cryptotronix/breakingbitcoin-hw/Graphics/BB2.bmp

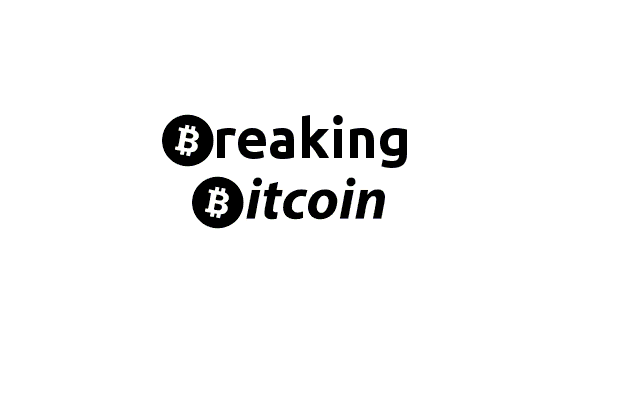
Graphics/BB2.bmp
