cryptotronix/breakingbitcoin-hw/Graphics/BBB.png

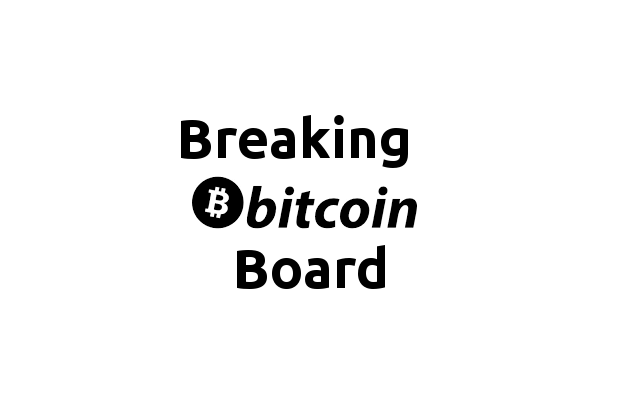
Graphics/BBB.png
