cryptotronix/breakingbitcoin-hw/Graphics/bitcoin.png

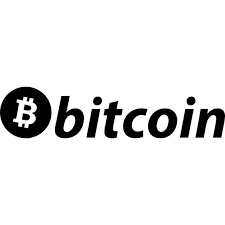
Graphics/bitcoin.png
