cryptotronix/breakingbitcoin-hw/Graphics/Cryptotronix.bmp

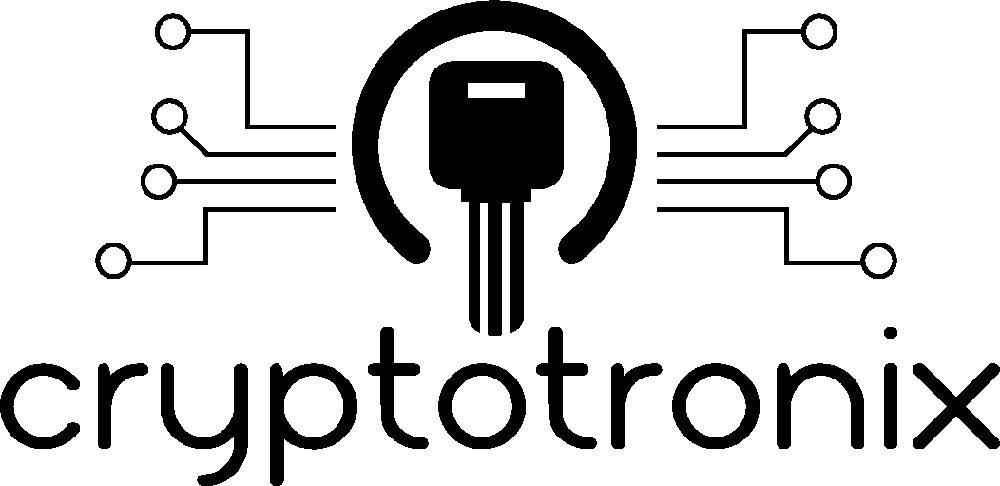
Graphics/Cryptotronix.bmp
