cryptotronix/breakingbitcoin-hw/Rev B/breaking_bitcoin-schematic.pdf

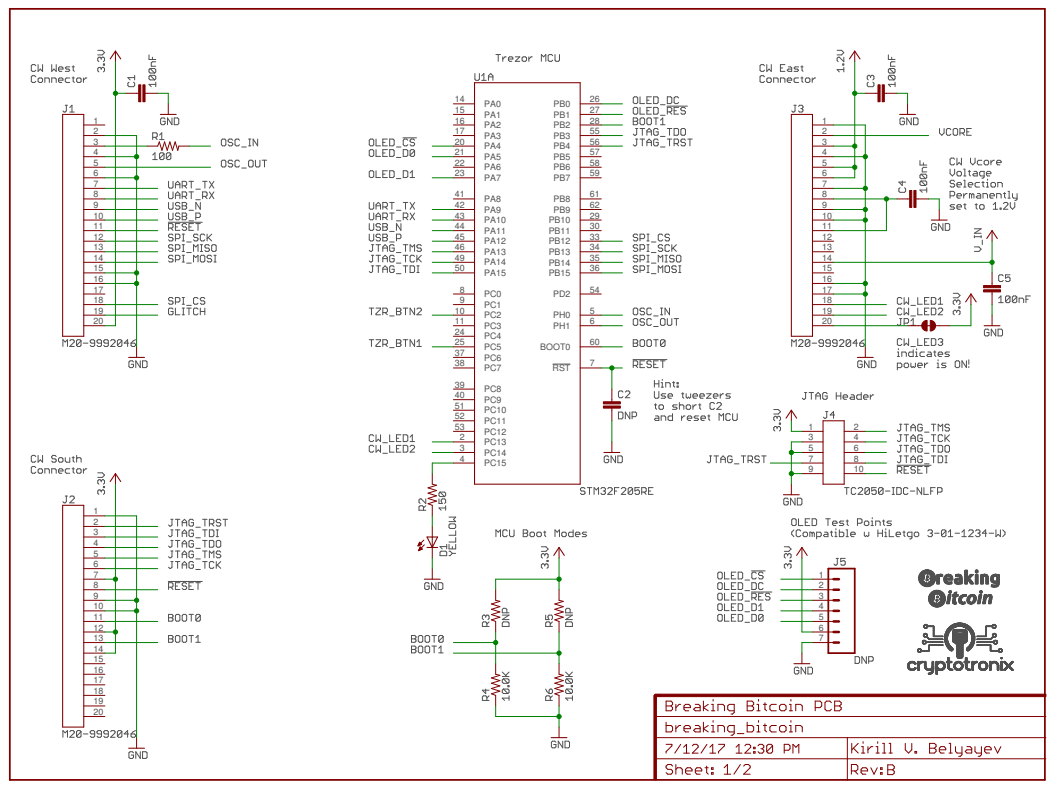
[picture p5: page 1]

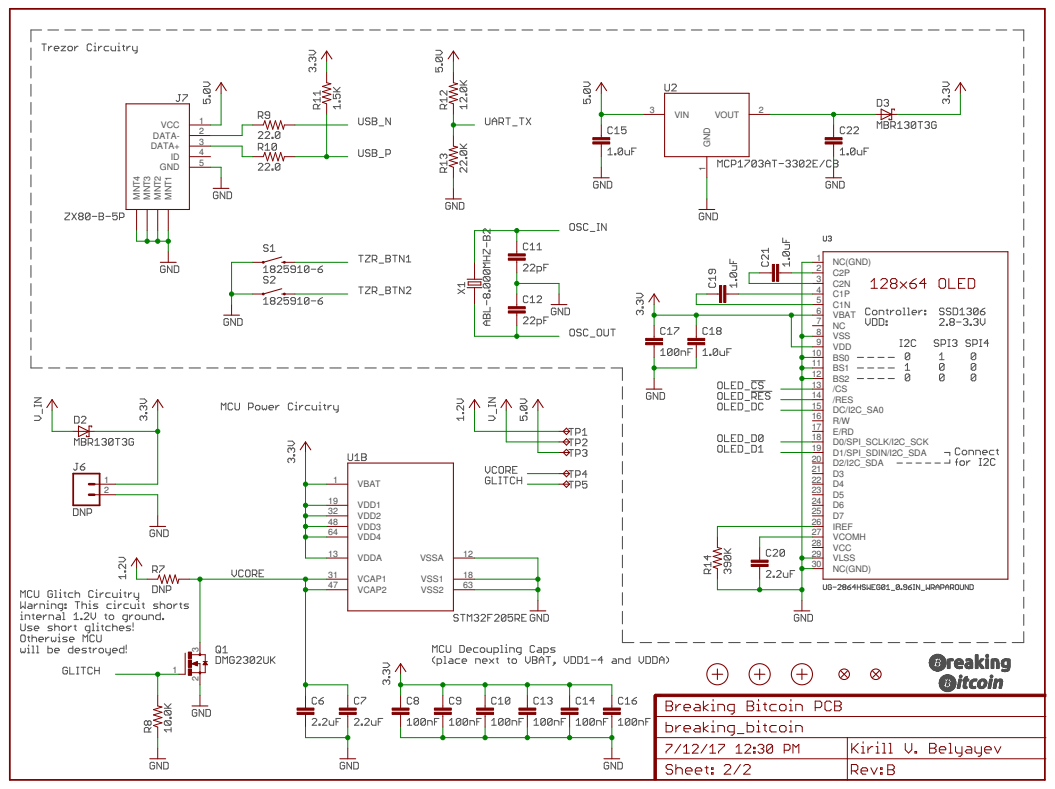
[picture p6: page 2]
