cryptotronix/breakingbitcoin-hw/Rev B/breaking_bitcoin-bottom.pdf

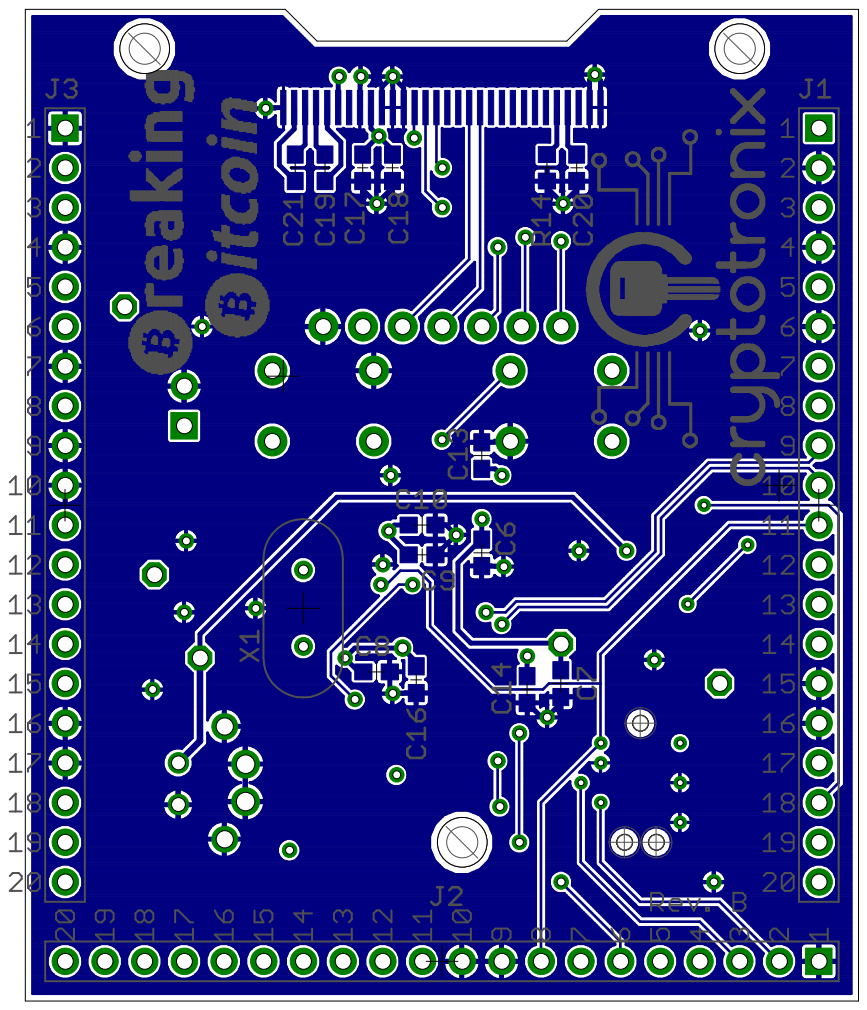
[picture p7: page 1]
