cryptotronix/breakingbitcoin-hw/Rev B/breaking_bitcoin-dimensions.pdf

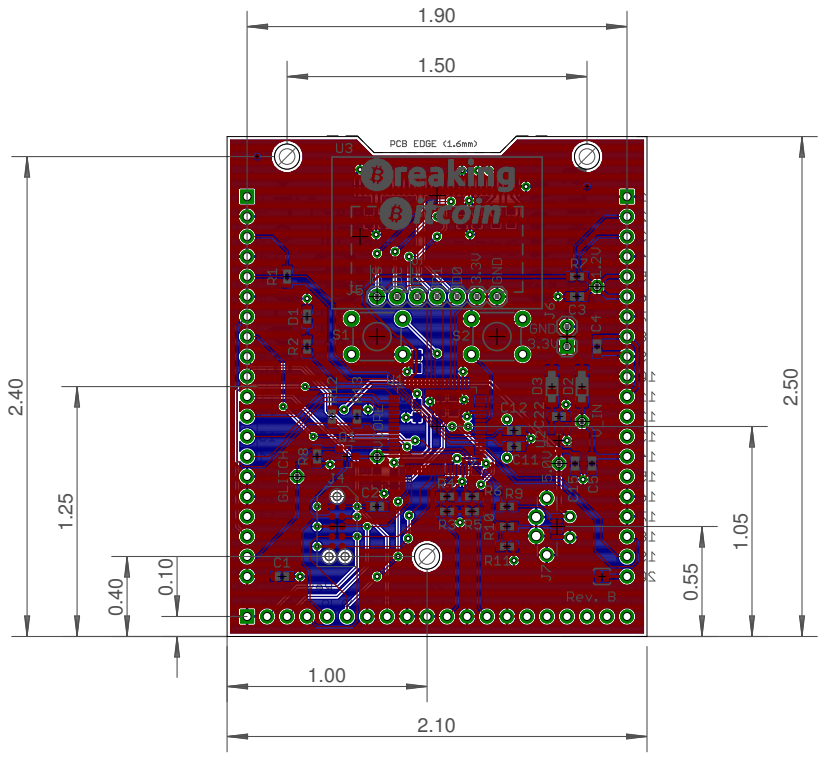
[picture p8: page 1]
