cryptotronix/breakingbitcoin-hw/Rev B/breaking_bitcoin-top.pdf

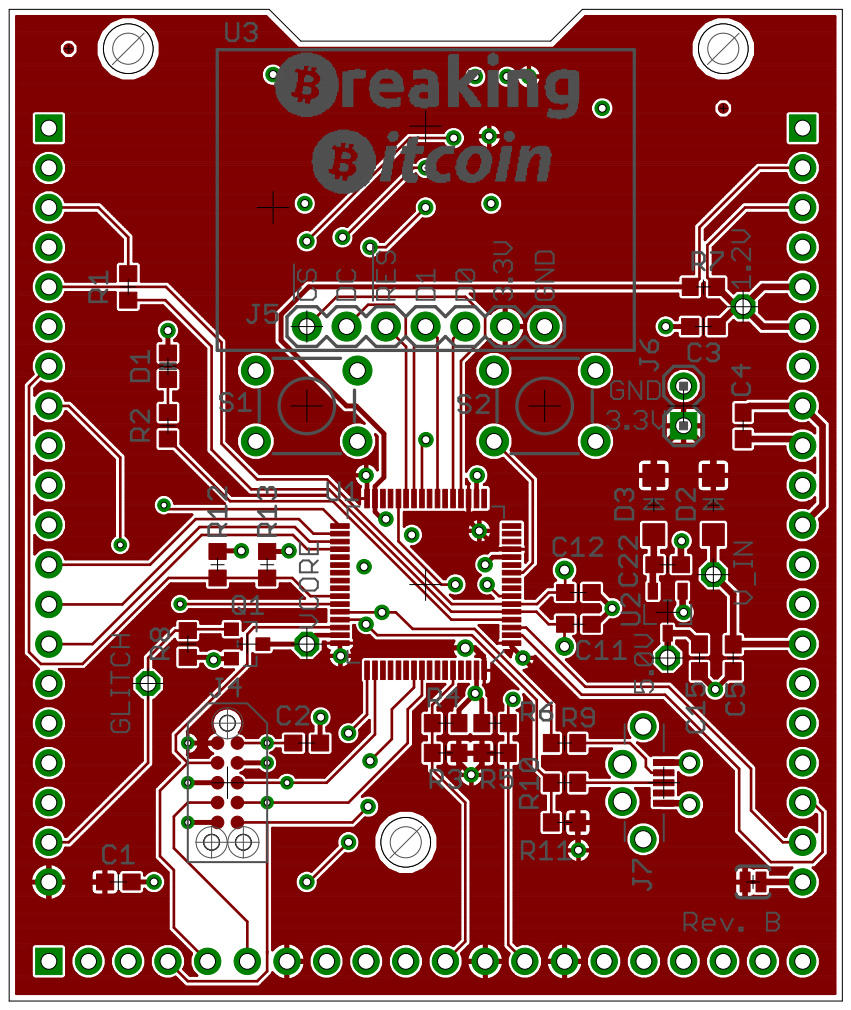
[picture p9: page 1]
