cryptotronix/breakingbitcoin-hw/Rev A/breaking_bitcoin-schematic.pdf

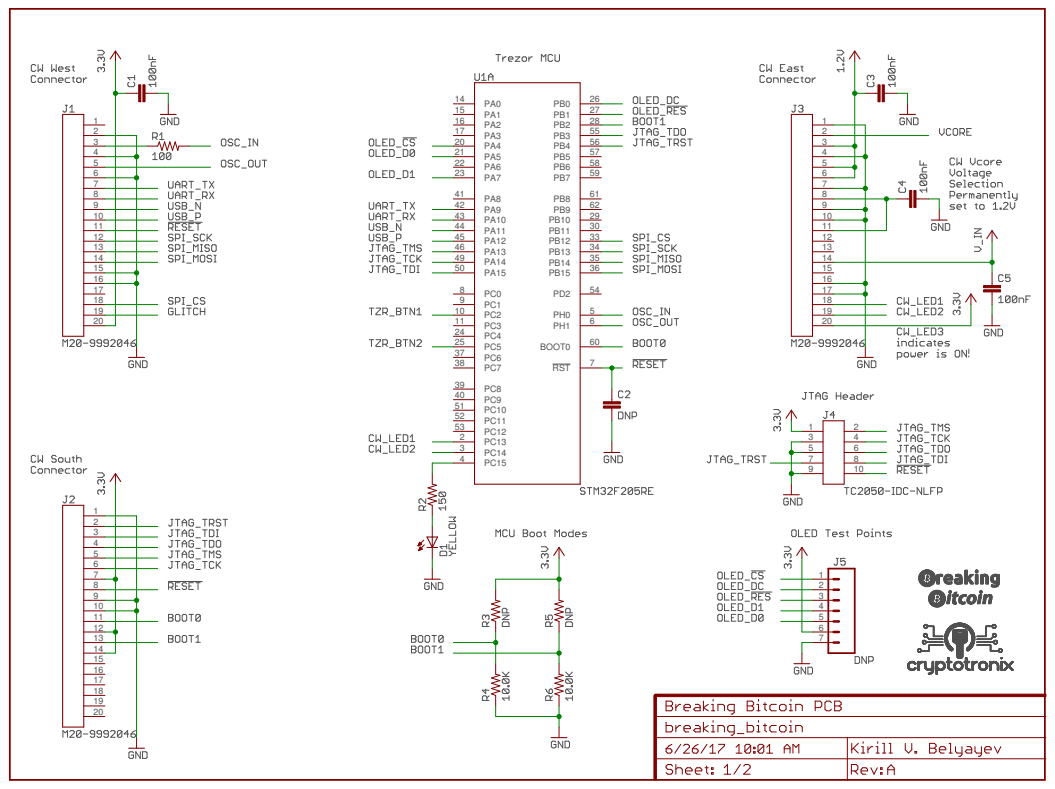
[picture p10: page 1]

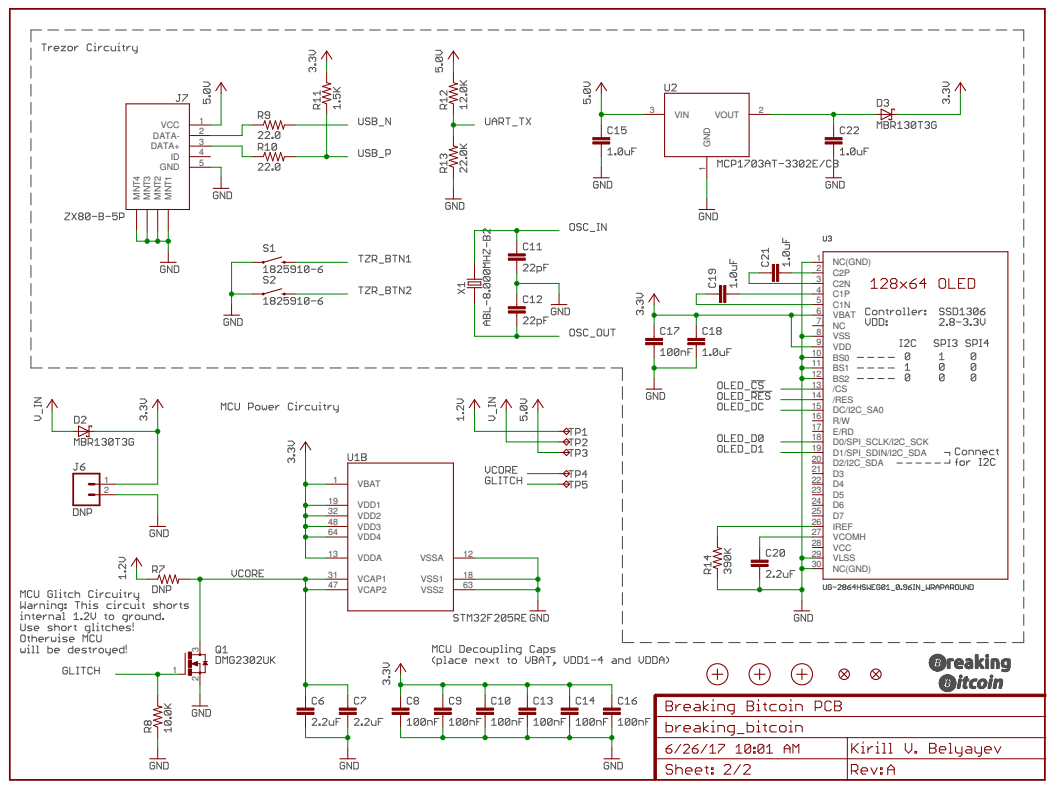
[picture p11: page 2]
