cryptotronix/breakingbitcoin-hw/Rev A/breaking_bitcoin-bottom.pdf

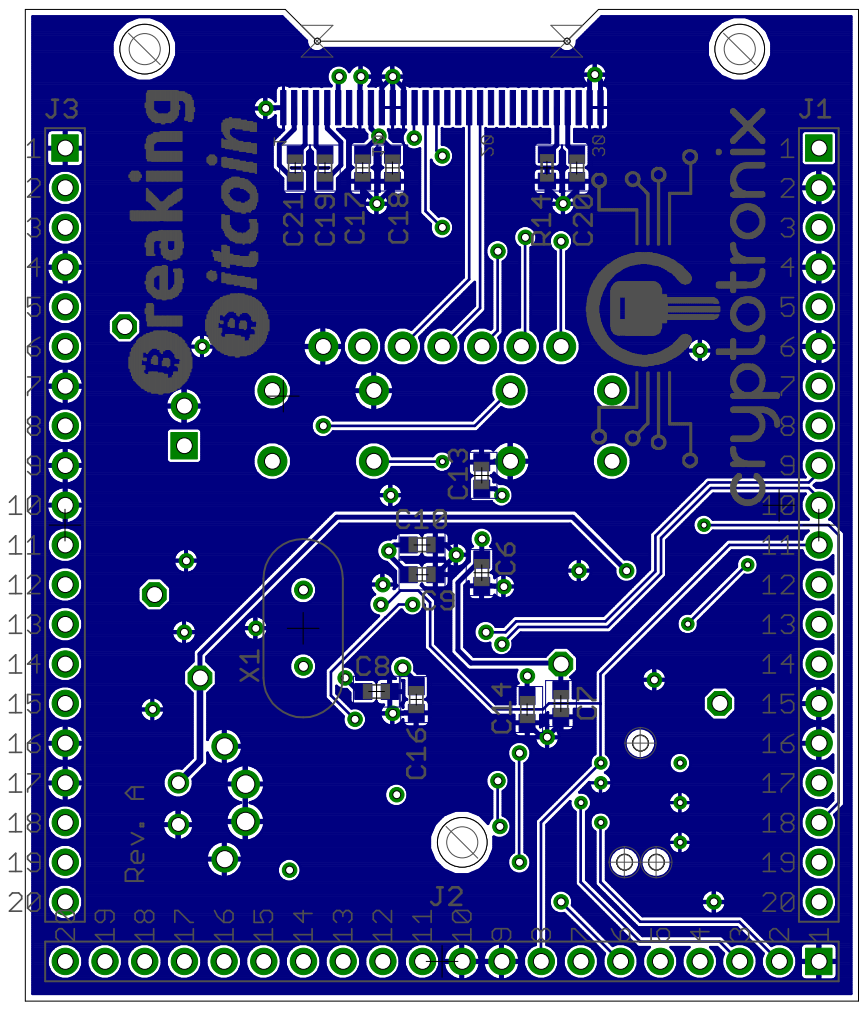
[picture p12: page 1]
