cryptotronix/breakingbitcoin-hw/Rev A/breaking_bitcoin-dimensions.pdf

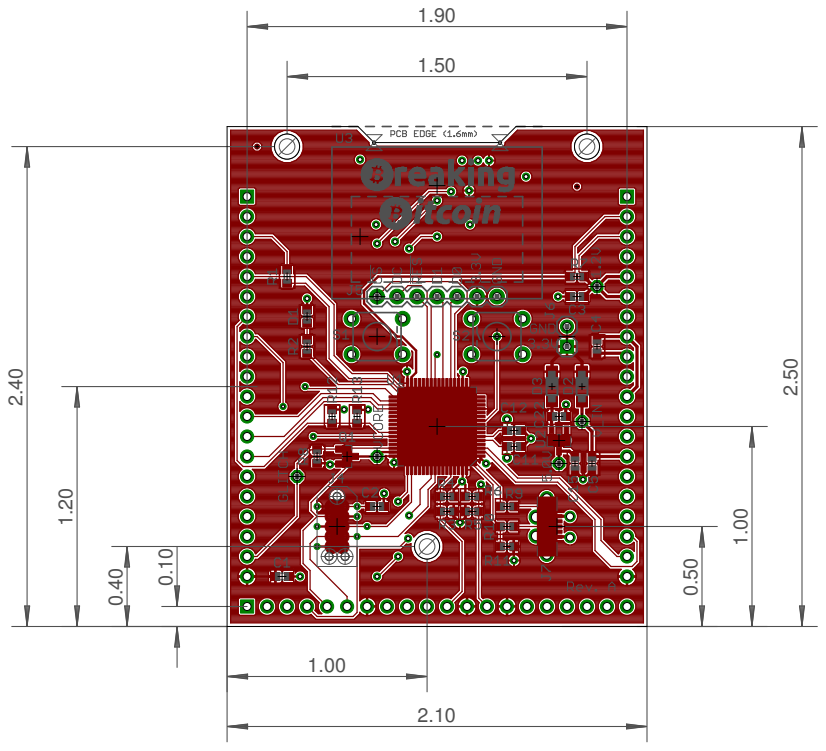
[picture p13: page 1]
