cryptotronix/breakingbitcoin-hw/Rev A/breaking_bitcoin-top.pdf

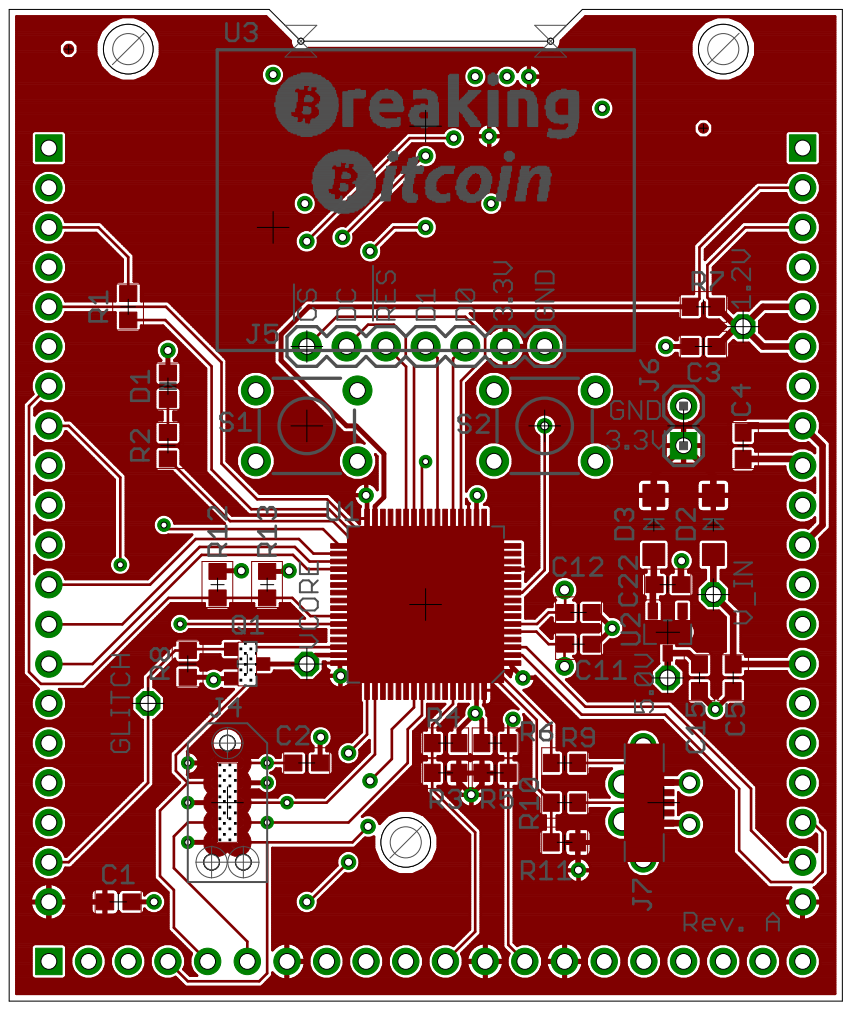
[picture p14: page 1]
