cryptotronix/breakingbitcoin-hw/Rev B/breaking_bitcoin.brd

## EAGLE design Rev B/breaking_bitcoin.brd (2017-07-13)

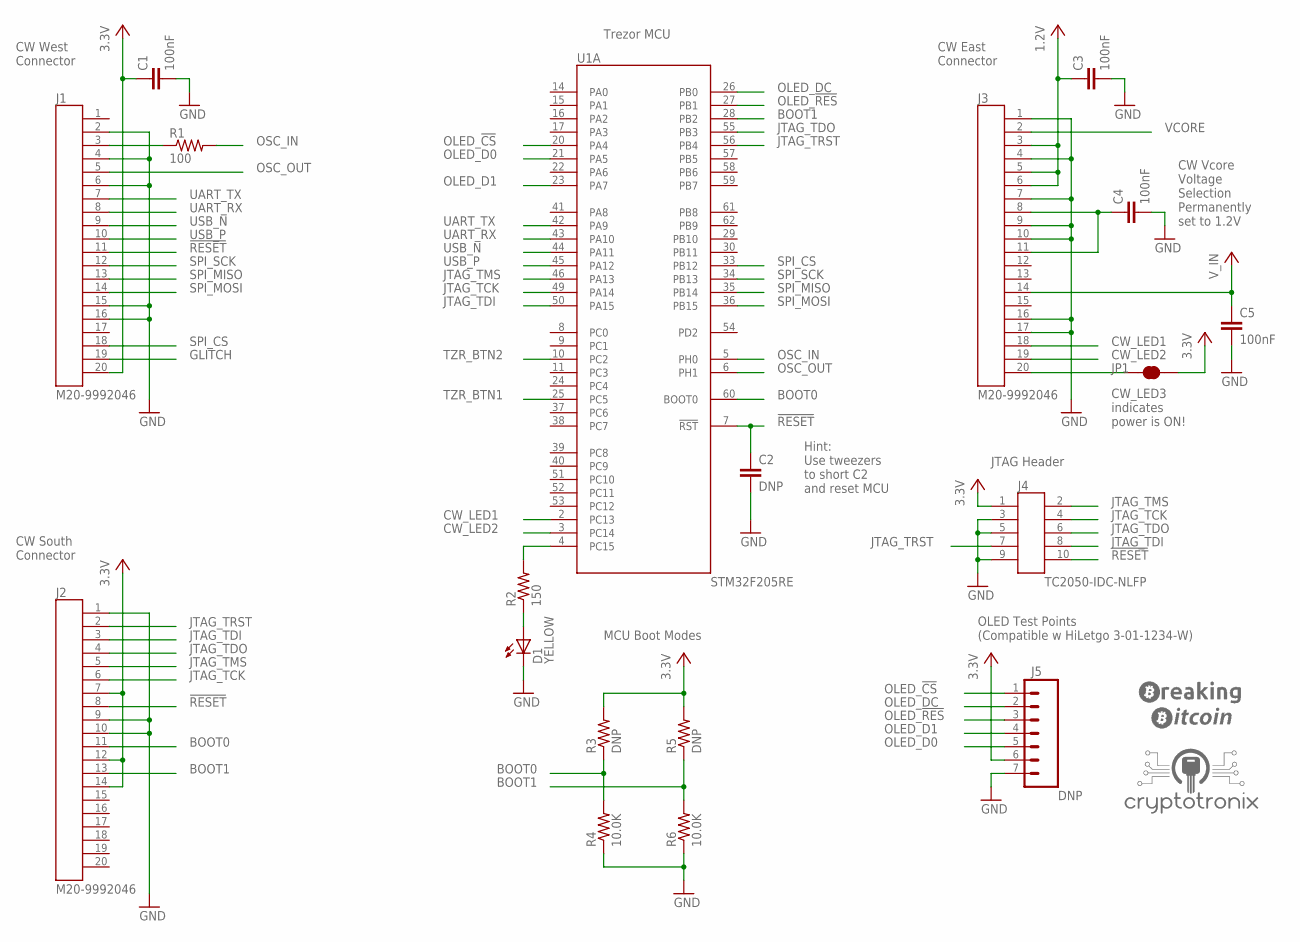
[picture p15: schematic breaking_bitcoin.sch, sheet 1]

Parts:
C1, C3, C4, C5: 100nF; C0603
C2: DNP; C0603
D1: YELLOW; 0603
J1, J2, J3: M20-9992046
J4: TC2050-IDC-NLFP
J5: DNP; 1X07
JP1: JUMPER-PAD-2-NC_BY_TRACE; PAD-JUMPER-2-NC_BY_TRACE_YES_SILK
R1: 100; R0603
R2: 150; R0603
R3, R5: DNP; R0603
R4, R6: 10.0K; R0603
U1: STM32F205RE; LQFP64
U$1: BB_LOGO
U$2: CRYPTOTRONIX_LOGO

Connections:
0V: C1.2, C2.2, C3.2, C4.2, C5.2, D1.C, J1.2, J1.4, J1.6, J1.15, J1.16, J2.1, J2.9, J2.10, J3.1, J3.4, J3.7, J3.9, J3.10, J3.16, J3.17, J4.3, J4.5, J4.9, J5.7, R4.1, R6.1; also elsewhere on the board
1.2V: C3.1, J3.3, J3.5, J3.6; also elsewhere on the board
3.3V: C1.1, J1.20, J2.7, J2.12, J2.14, J4.1, J5.6, JP1.2, R3.2, R5.2; also elsewhere on the board
!RESET: C2.1, J1.11, J2.8, J4.10, U1.7 (!RST)
BOOT0: J2.11, R3.1, R4.2, U1.60 (BOOT0)
BOOT1: J2.13, R5.1, R6.2, U1.28 (PB2)
CW_LED1: J3.18, U1.2 (PC13)
CW_LED2: J3.19, U1.3 (PC14)
GLITCH: J1.19; also elsewhere on the board
JTAG_TCK: J2.6, J4.4, U1.49 (PA14)
JTAG_TDI: J2.3, J4.8, U1.50 (PA15)
JTAG_TDO: J2.4, J4.6, U1.55 (PB3)
JTAG_TMS: J2.5, J4.2, U1.46 (PA13)
JTAG_TRST: J2.2, J4.7, U1.56 (PB4)
unnamed: J1.3, R1.1
unnamed: R2.2, U1.4 (PC15)
unnamed: C4.1, J3.8, J3.11
unnamed: D1.A, R2.1
unnamed: J3.20, JP1.1
OLED_!CS: J5.1, U1.20 (PA4); also elsewhere on the board
OLED_!RES: J5.3, U1.27 (PB1); also elsewhere on the board
OLED_D0: J5.5, U1.21 (PA5); also elsewhere on the board
OLED_D1: J5.4, U1.23 (PA7); also elsewhere on the board
OLED_DC: J5.2, U1.26 (PB0); also elsewhere on the board
OSC_IN: R1.2, U1.5 (PH0); also elsewhere on the board
OSC_OUT: J1.5, U1.6 (PH1); also elsewhere on the board
SPI_CS: J1.18, U1.33 (PB12)
SPI_MISO: J1.13, U1.35 (PB14)
SPI_MOSI: J1.14, U1.36 (PB15)
SPI_SCK: J1.12, U1.34 (PB13)
TZR_BTN1: U1.25 (PC5); also elsewhere on the board
TZR_BTN2: U1.10 (PC2); also elsewhere on the board
UART_RX: J1.8, U1.43 (PA10)
UART_TX: J1.7, U1.42 (PA9); also elsewhere on the board
USB_N: J1.9, U1.44 (PA11); also elsewhere on the board
USB_P: J1.10, U1.45 (PA12); also elsewhere on the board
VCORE: J3.2; also elsewhere on the board
V_IN: C5.1, J3.14; also elsewhere on the board

Notes on the sheet:
Trezor MCU
CW West Connector
CW South Connector
CW East Connector
JTAG Header
MCU Boot Modes
CW Vcore Voltage Selection Permanently set to 1.2V
CW_LED3 indicates power is ON!
OLED Test Points (Compatible w HiLetgo 3-01-1234-W)
Hint: Use tweezers to short C2 and reset MCU

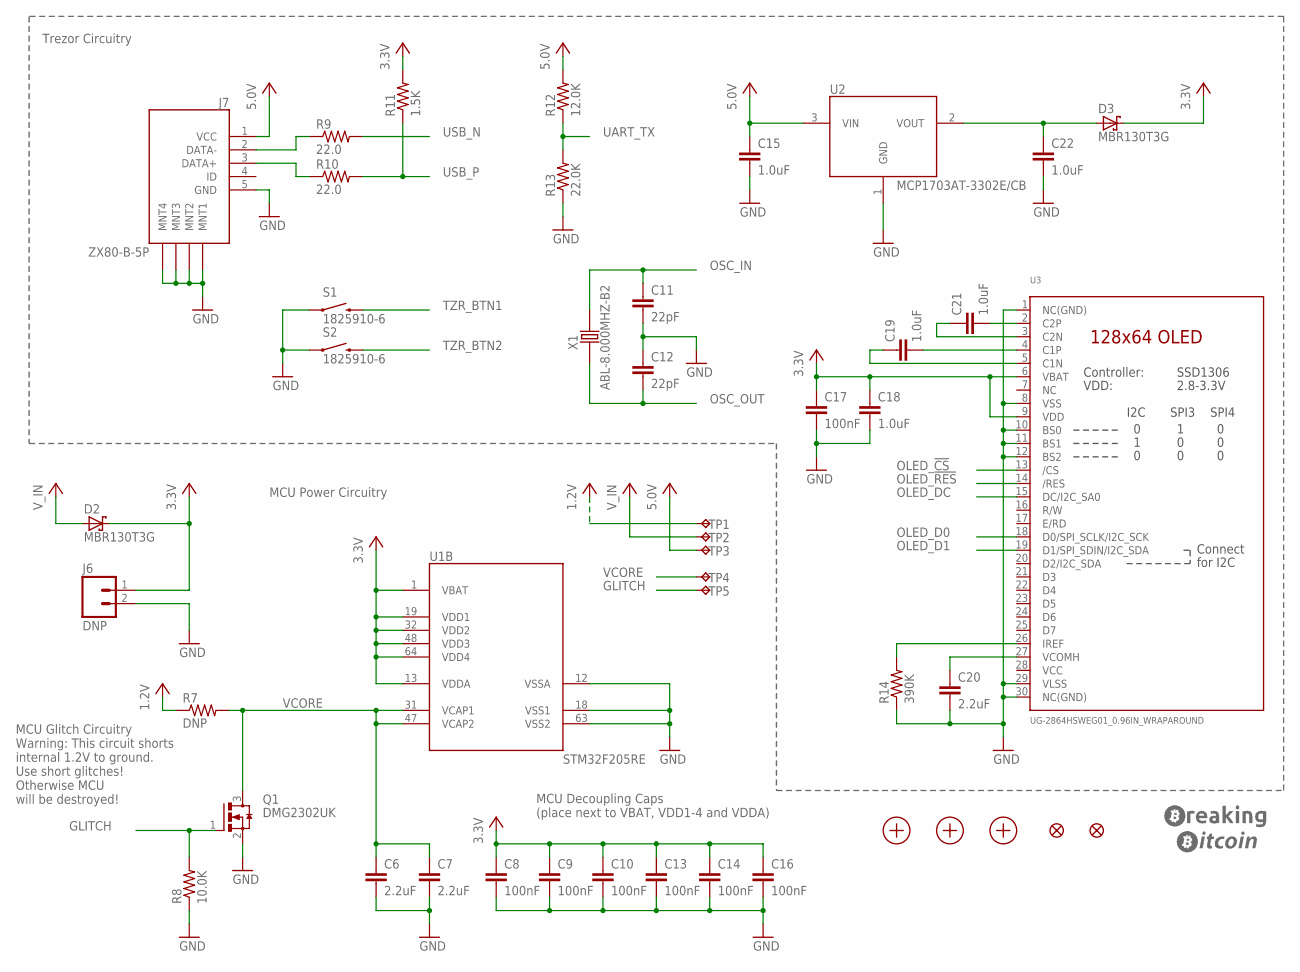
[picture p16: schematic breaking_bitcoin.sch, sheet 2]

Parts:
C6, C7, C20: 2.2uF; C0603
C8, C9, C10, C13, C14, C16, C17: 100nF; C0603
C11, C12: 22pF; C0603
C15, C18, C19, C21, C22: 1.0uF; C0603
D2, D3: MBR130T3G; SOD123
FD1, FD2: FIDUCIALUFIDUCIAL; MICRO-FIDUCIAL
J6: DNP; M20-9990246
J7: ZX80-B-5P
MNT1, MNT2, MNT3: MOUNT-HOLE-NO-PLATE4-40; MOUNT-HOLE-NO-PLATE-4-40
Q1: DMG2302UK
R7: DNP; R0603
R8: 10.0K; R0603
R9, R10: 22.0; R0603
R11: 1.5K; R0603
R12: 12.0K; R0603
R13: 22.0K; R0603
R14: 390K; R0603
S1, S2: 1825910-6; SWITCH-TACT-TH
TP1, TP2, TP3, TP4, TP5: TEST-POINT40MIL; TEST-POINT-40MILL
U1: STM32F205RE; LQFP64
U2: MCP1703AT-3302E/CB
U3: UG-2864HSWEG01_0.96IN_WRAPAROUND
U$3: BB_LOGO
X1: ABL-8.000MHZ-B2

Connections:
0V: C6.2, C7.2, C8.2, C9.2, C10.2, C11.2, C12.1, C13.2, C14.2, C15.2, C16.2, C17.2, C18.2, C20.2, C22.2, J6.2, J7.5 (GND), J7.M1 (MNT1), J7.M2 (MNT2), J7.M3 (MNT3), J7.M4 (MNT4), Q1.2 (S), R8.1, R13.1, R14.1, S1.1, S2.1, U1.12 (VSSA), U1.18 (VSS1), U1.63 (VSS2), U2.1 (GND), U3.1 (NC(GND)), U3.8 (VSS), U3.10 (BS0), U3.11 (BS1), U3.12 (BS2), U3.29 (VLSS), U3.30 (NC(GND)); also elsewhere on the board
1.2V: R7.1, TP1.1; also elsewhere on the board
3.3V: C8.1, C9.1, C10.1, C13.1, C14.1, C16.1, C17.1, C18.1, D2.C, D3.C, J6.1, R11.2, U1.1 (VBAT), U1.13 (VDDA), U1.19 (VDD1), U1.32 (VDD2), U1.48 (VDD3), U1.64 (VDD4), U3.6 (VBAT), U3.9 (VDD); also elsewhere on the board
5.0V: C15.1, J7.1 (VCC), R12.2, TP3.1, U2.3 (VIN)
GLITCH: Q1.1 (G), R8.2, TP5.1; also elsewhere on the board
unnamed: C19.1, U3.5 (C1N)
unnamed: C22.1, D3.A, U2.2 (VOUT)
unnamed: C19.2, U3.4 (C1P)
unnamed: C21.2, U3.2 (C2P)
unnamed: J7.2 (DATA-), R9.1
unnamed: J7.3 (DATA+), R10.1
unnamed: C21.1, U3.3 (C2N)
unnamed: C20.1, U3.27 (VCOMH)
unnamed: R14.2, U3.26 (IREF)
OLED_!CS: U3.13 (/CS); also elsewhere on the board
OLED_!RES: U3.14 (/RES); also elsewhere on the board
OLED_D0: U3.18 (D0/SPI_SCLK/I2C_SCK); also elsewhere on the board
OLED_D1: U3.19 (D1/SPI_SDIN/I2C_SDA); also elsewhere on the board
OLED_DC: U3.15 (DC/I2C_SA0); also elsewhere on the board
OSC_IN: C11.1, X1.2; also elsewhere on the board
OSC_OUT: C12.2, X1.1; also elsewhere on the board
TZR_BTN1: S1.3 (2); also elsewhere on the board
TZR_BTN2: S2.3 (2); also elsewhere on the board
UART_TX: R12.1, R13.2; also elsewhere on the board
USB_N: R9.2; also elsewhere on the board
USB_P: R10.2, R11.1; also elsewhere on the board
VCC: U3.28 (VCC)
VCORE: C6.1, C7.1, Q1.3 (D), R7.2, TP4.1, U1.31 (VCAP1), U1.47 (VCAP2); also elsewhere on the board
V_IN: D2.A, TP2.1; also elsewhere on the board

Notes on the sheet:
MCU Decoupling Caps (place next to VBAT, VDD1-4 and VDDA)
MCU Glitch Circuitry Warning: This circuit shorts internal 1.2V to ground. Use short glitches! Otherwise MCU will be destroyed!
MCU Power Circuitry
Trezor Circuitry

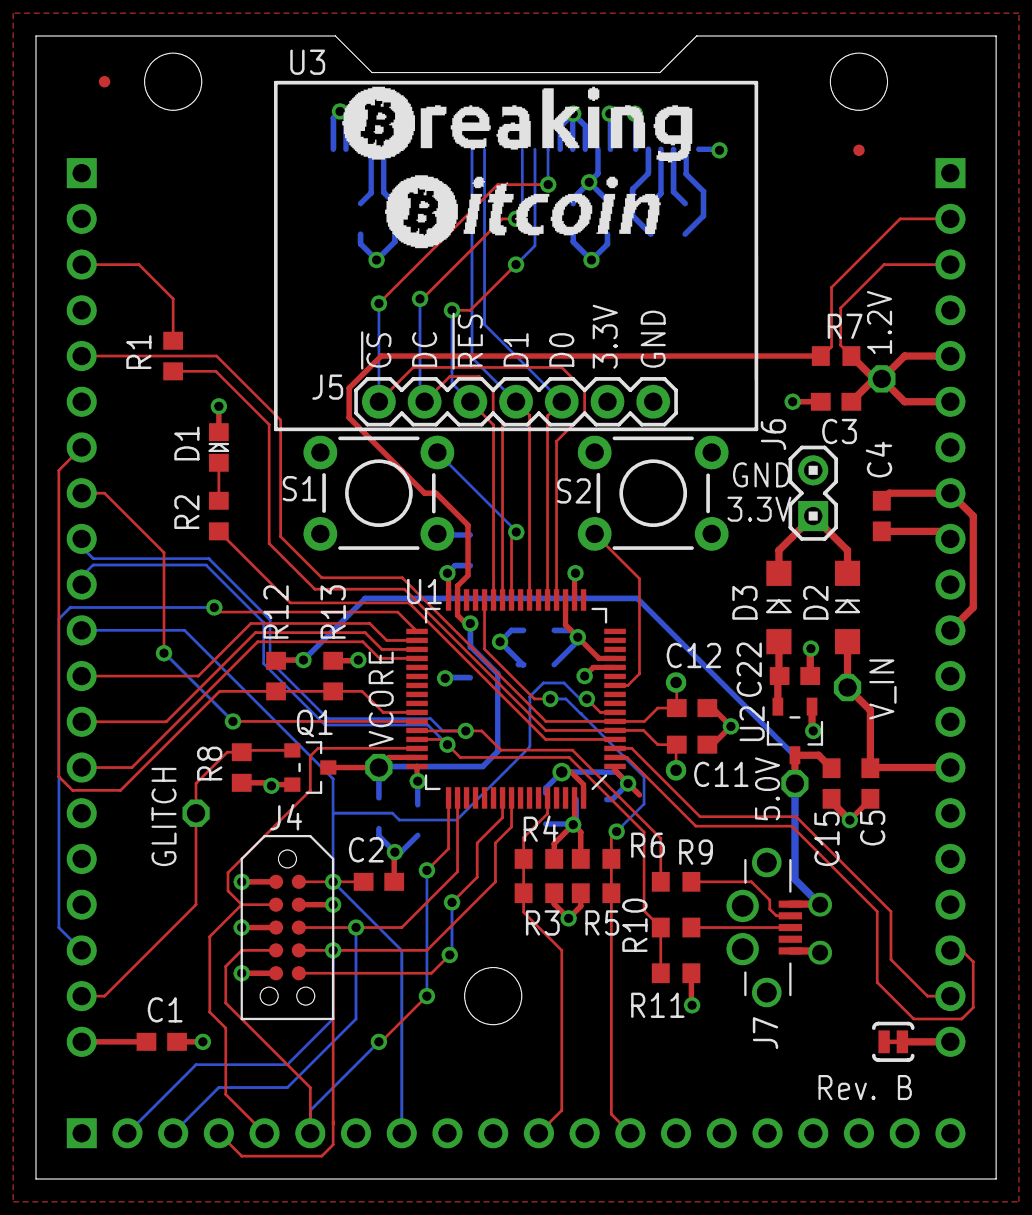
[picture p17: board breaking_bitcoin.brd from above]

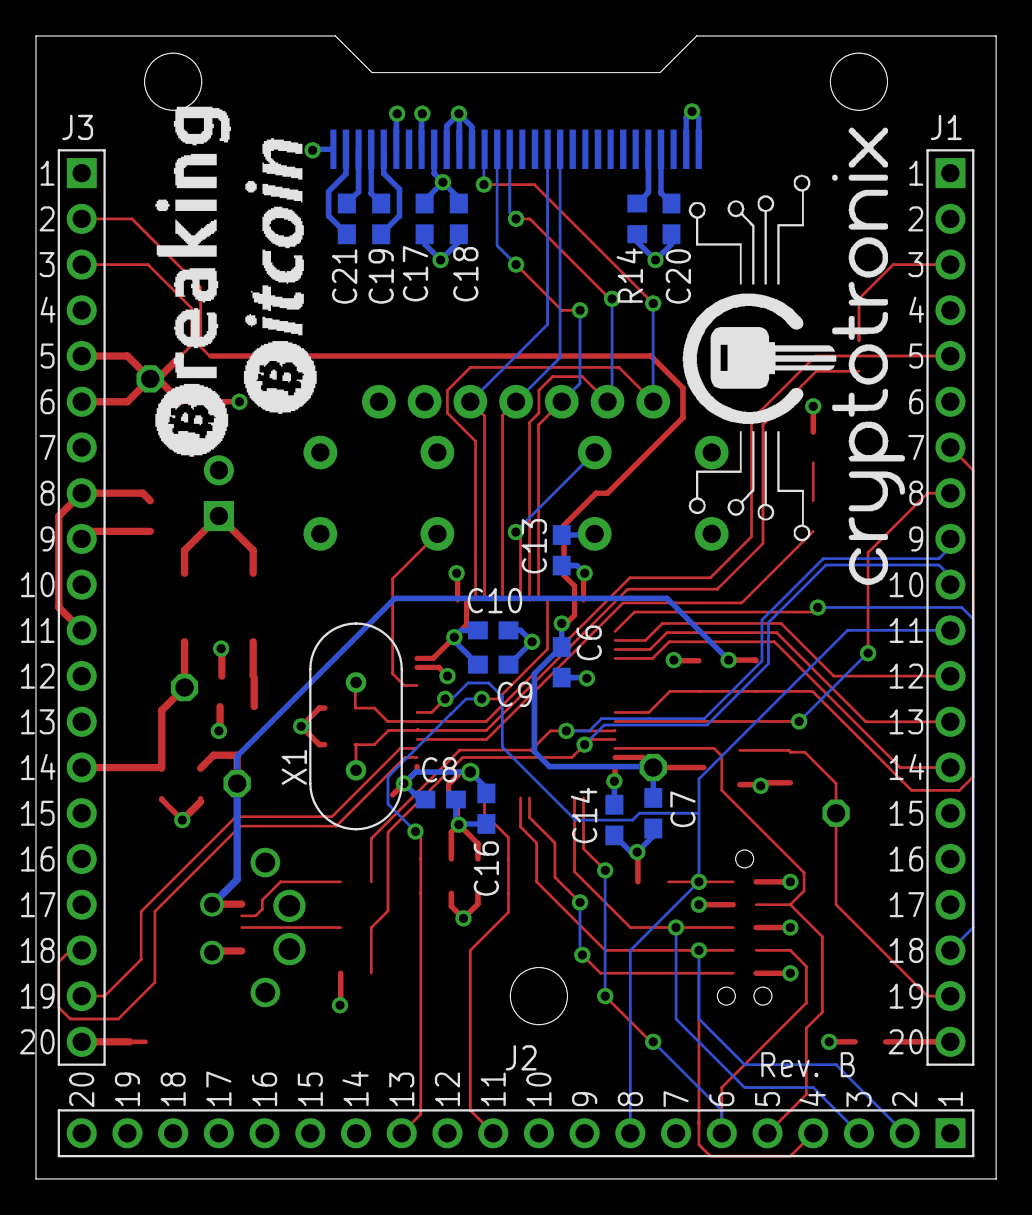
[picture p18: board breaking_bitcoin.brd from below]

Board: 2 copper layers, 53.3 x 63.5 mm, 67 parts (20 on the bottom side), 48 nets.
