cryptotronix/breakingbitcoin-hw/(commit log)

2017-06-23 Adding Rev. A of the Breaking Bitcoin board
    [breaking_bitcoin.brd, breaking_bitcoin.sch]
2017-06-23 Adding BOM/Gerbers
    [breaking_bitcoin.brd, breaking_bitcoin.sch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]
2017-06-23 Updating silkscreen
    [breaking_bitcoin.brd, breaking_bitcoin.sch]
2017-06-26 Improving 3.3V power plane
    [breaking_bitcoin.brd, breaking_bitcoin.sch]
2017-06-26 Some cosmetic improvements to the schematic
    [breaking_bitcoin.sch]
2017-06-26 Adding read_me for the gerbers
2017-06-27 Removing drill holes marking OLED ffc edge
    [breaking_bitcoin.brd, breaking_bitcoin.sch]
2017-06-28 Adding Rev. B. Fixing button mixup
    [breaking_bitcoin.brd, breaking_bitcoin.sch]
2017-06-29 Fixing south bridge for the Rev. B
    [breaking_bitcoin.brd, breaking_bitcoin.sch]
2017-07-08 Generating gerbers for Rev. B
    [breaking_bitcoin.brd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]
2017-07-10 Rev. B BOM and CPL
    [breaking_bitcoin-CPL.csv, breaking_bitcoin-CPL.ods]
2017-07-10 Updating CPL
    [breaking_bitcoin-CPL.csv, breaking_bitcoin-CPL.ods]
2017-07-12 Adding reset MCU hint notes
    [breaking_bitcoin.sch]
2017-07-13 Changing all via sizes to 20mil
    [breaking_bitcoin.brd]
2017-07-27 Adding BB Parts Kit
    [BB_Parts_Kit.ods]
2017-07-27 BB Parts Kit 2
    [BB_Parts_Kit.ods]
